hackup/C128Diag/README.md

# C128 Diagnostic Cartridge 325093-01 Replica

This is a 1:1 replica of the PCB for the Commodore C128 Diagnostic Test cartridge assy no. 325093-01. See my [blog post](https://www.hackup.net/2023/05/c128-diagnostic-cartridge-325093-01-replicated/) for more details.

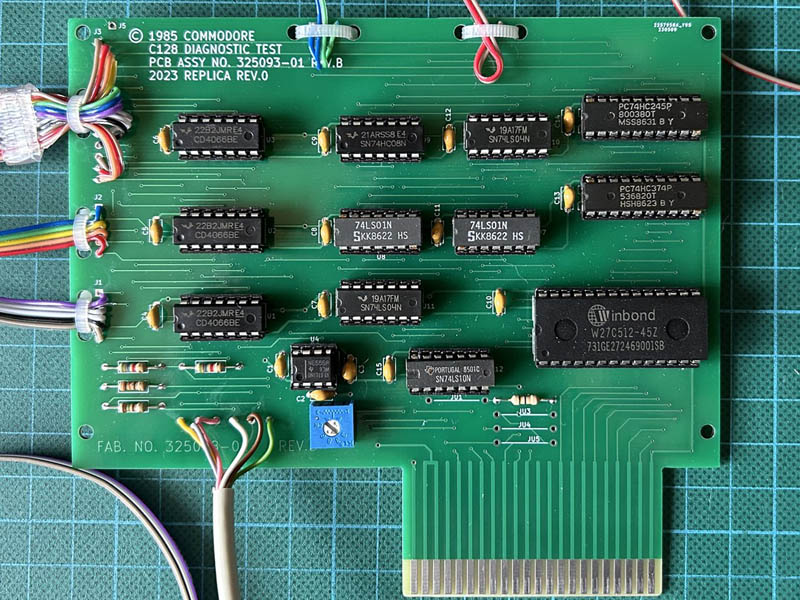
[picture p1: media/C128Diag-1.jpg]
C128Diag Replica Rev.0


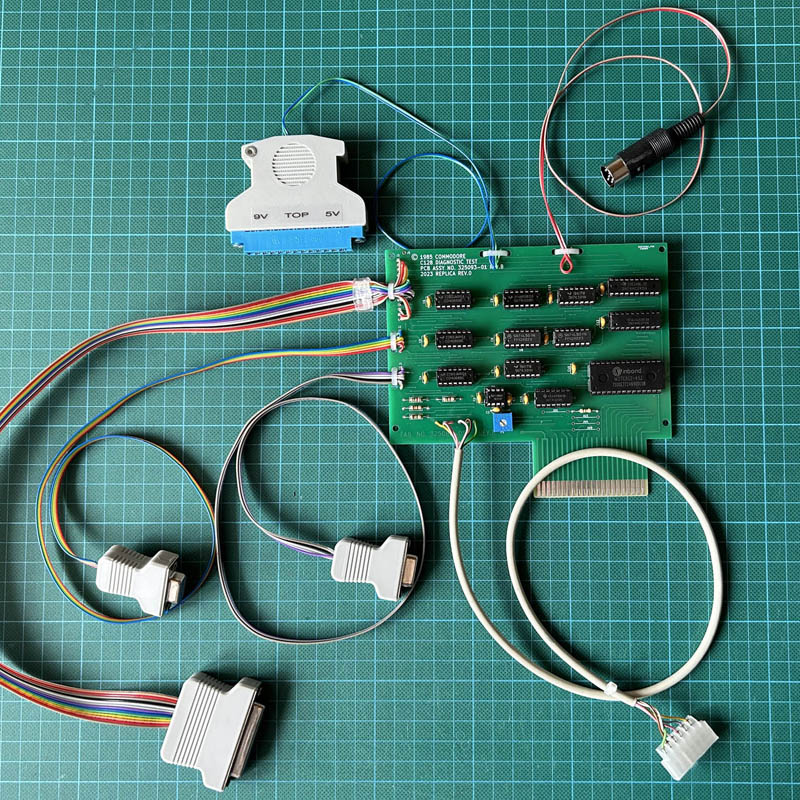
[picture p2: media/C128Diag-2.jpg]
C128Diag Replica Rev.0 with test harness


## License


This work is licensed under a
[Creative Commons Attribution-NonCommercial-ShareAlike 4.0 International License](http://creativecommons.org/licenses/by-nc-sa/4.0/).
