hackup/C128Diag/C128Diag.pdf

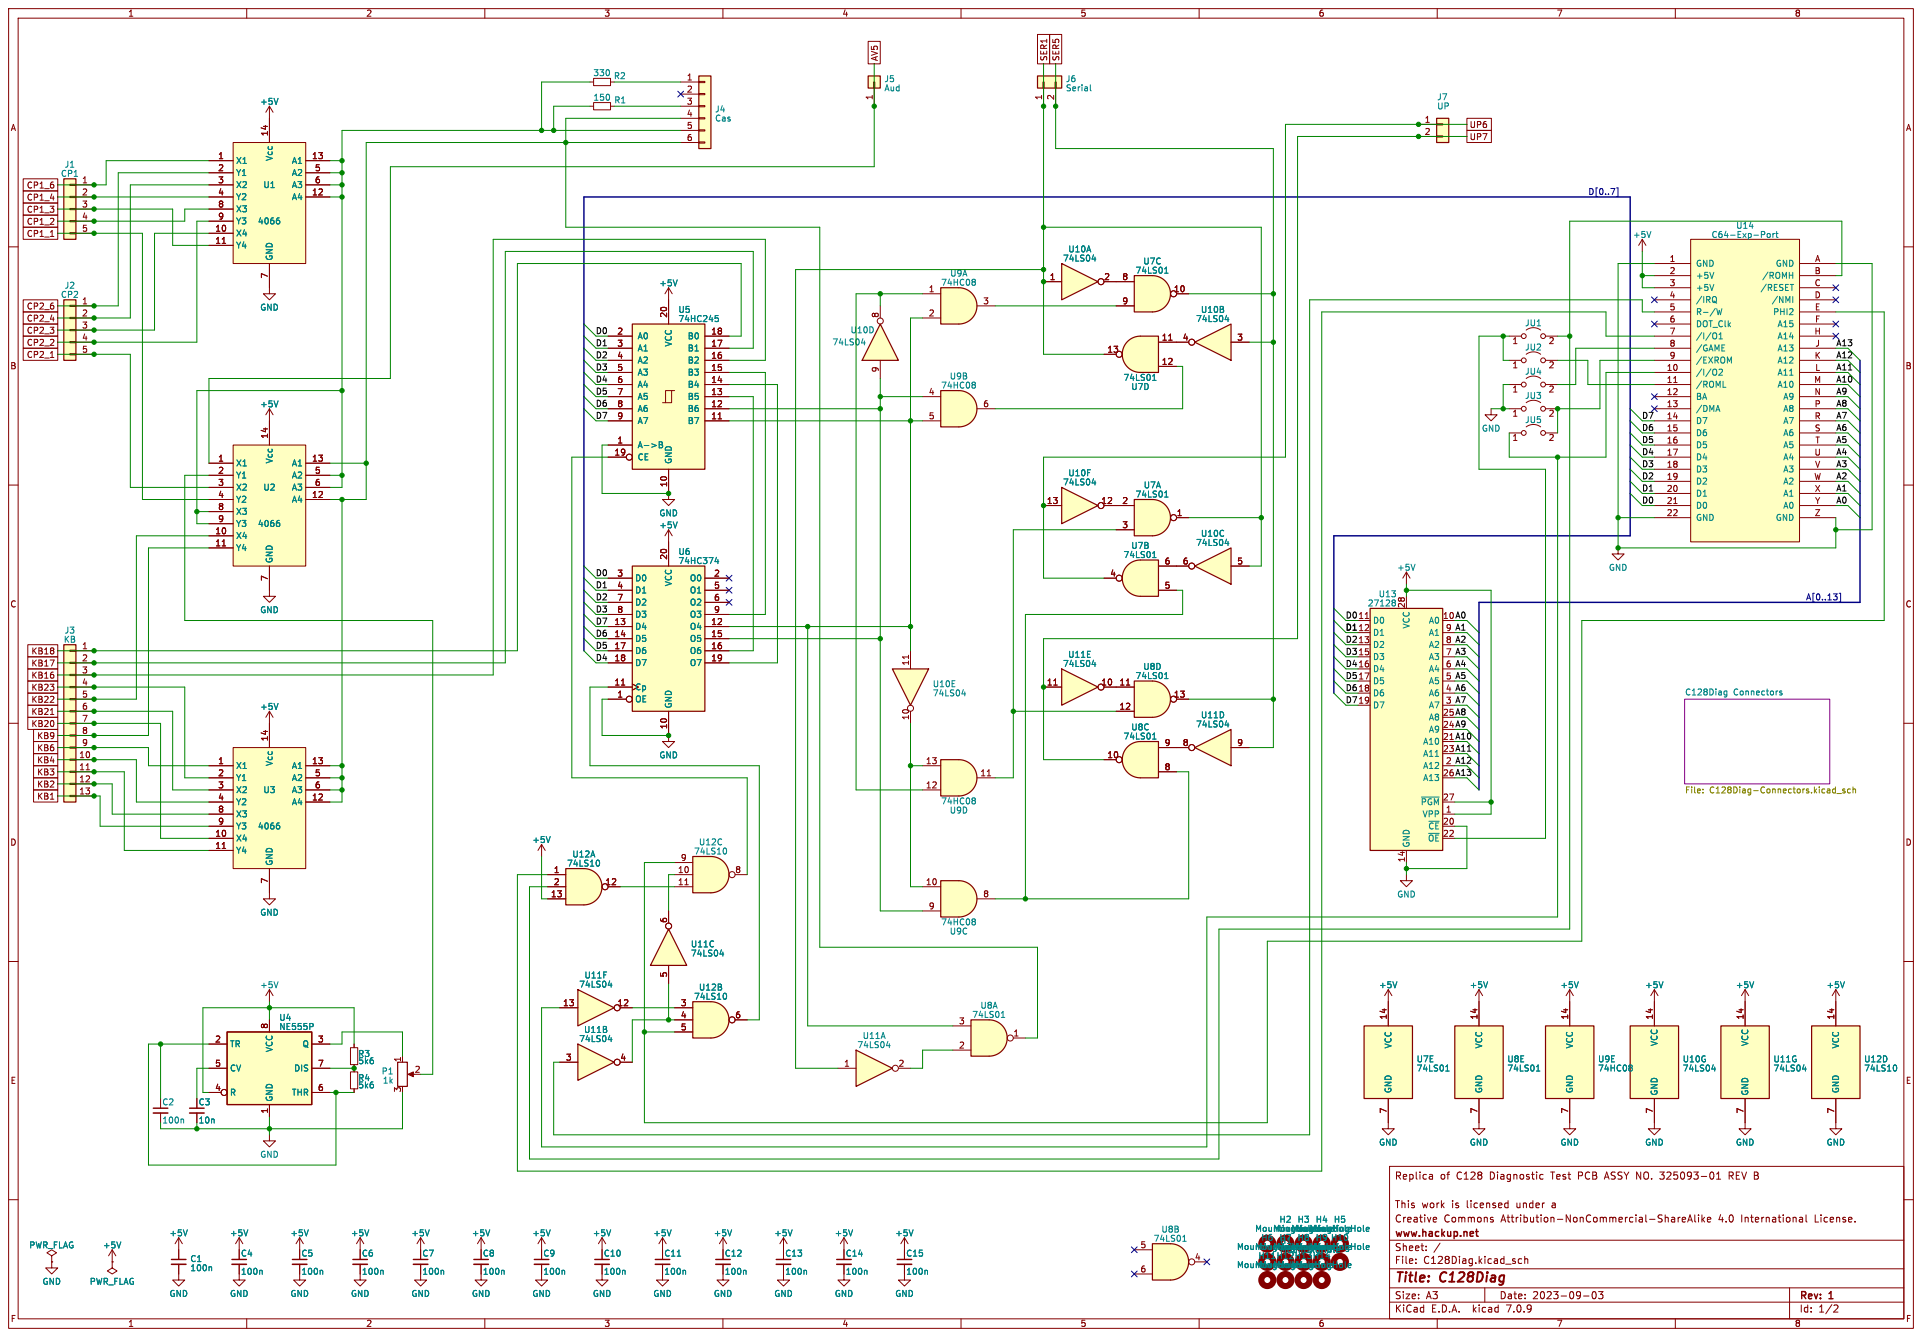
[picture p3: page 1]

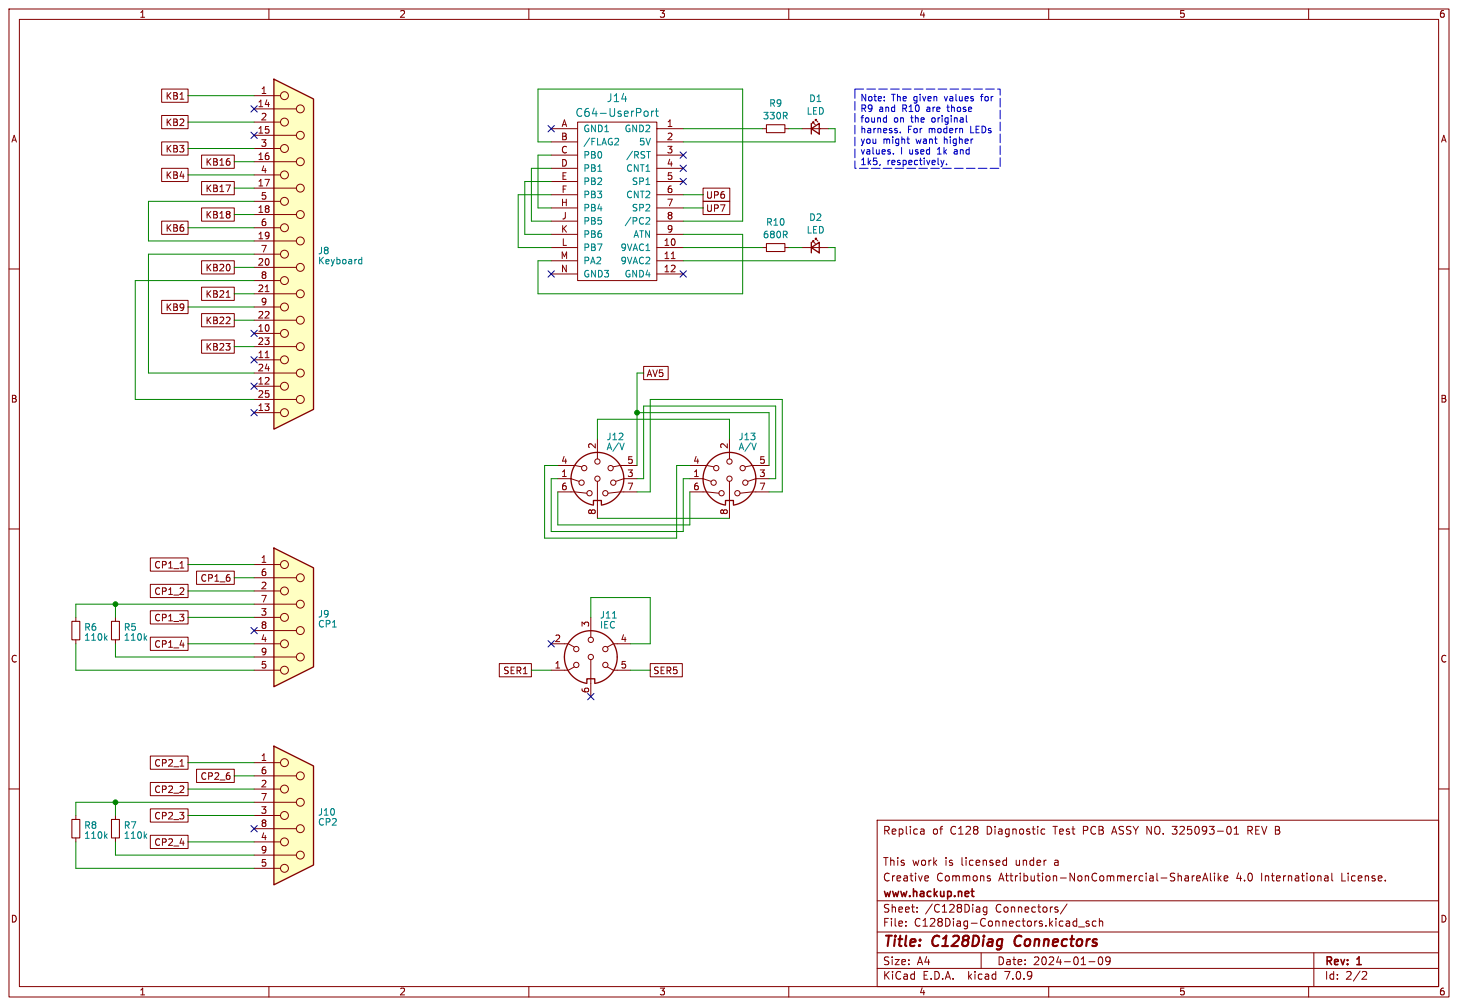
[picture p4: page 2]

found on the original harness. For modern LEDs

you might want higher values. I used 1k and
