hackup/C128Diag/C128Diag-Connectors.kicad_sch

## KiCad design C128Diag-Connectors.kicad_sch (2024-01-09)

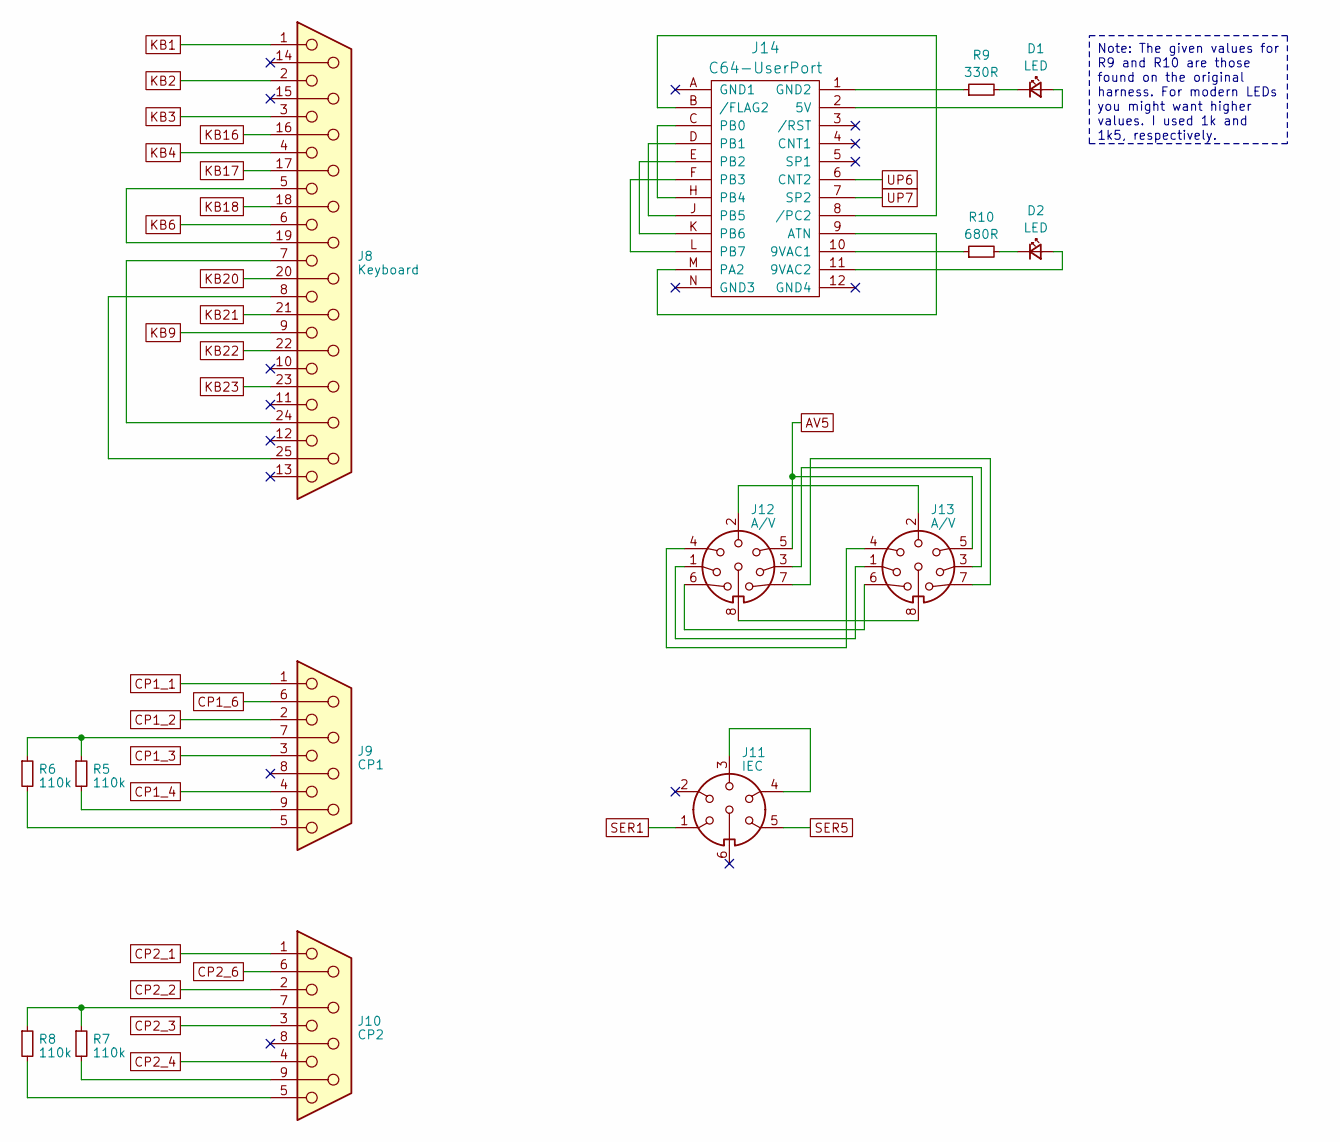
[picture p5: schematic C128Diag-Connectors.kicad_sch]

Parts:
D1, D2: LED
J8: Keyboard
J9: CP1
J10: CP2
J11: IEC
J12, J13: A/V
J14: C64-UserPort; C64-User-Port-Female
R5, R6, R7, R8: 110k
R9: 330R
R10: 680R

Connections:
AV5: J12.5, J13.5
CP1_1: J9.1
CP1_2: J9.2
CP1_3: J9.3
CP1_4: J9.4
CP1_6: J9.6
CP2_1: J10.1
CP2_2: J10.2
CP2_3: J10.3
CP2_4: J10.4
CP2_6: J10.6
KB1: J8.1
KB2: J8.2
KB3: J8.3
KB4: J8.4
KB6: J8.6
KB9: J8.9
KB16: J8.16
KB17: J8.17
KB18: J8.18
KB20: J8.20
KB21: J8.21
KB22: J8.22
KB23: J8.23
unnamed: D1.1 (K), R9.2
unnamed: D1.2 (A), J14.2 (5V)
unnamed: D2.1 (K), R10.2
unnamed: D2.2 (A), J14.11 (9VAC2)
unnamed: J8.5, J8.19
unnamed: J8.7, J8.24
unnamed: J8.8, J8.25
unnamed: J9.5, R6.2
unnamed: J9.7, R5.1, R6.1
unnamed: J9.9, R5.2
unnamed: J10.5, R8.2
unnamed: J10.7, R7.1, R8.1
unnamed: J10.9, R7.2
unnamed: J11.3, J11.4
unnamed: J12.1, J13.1
unnamed: J12.2, J13.2
unnamed: J12.3, J13.3
unnamed: J12.4, J13.4
unnamed: J12.6, J13.6
unnamed: J12.7, J13.7
unnamed: J12.8, J13.8
unnamed: J14.1 (GND2), R9.1
unnamed: J14.8 (/PC2), J14.B (/FLAG2)
unnamed: J14.9 (ATN), J14.M (PA2)
unnamed: J14.10 (9VAC1), R10.1
unnamed: J14.C (PB0), J14.H (PB4)
unnamed: J14.D (PB1), J14.J (PB5)
unnamed: J14.E (PB2), J14.K (PB6)
unnamed: J14.F (PB3), J14.L (PB7)
SER1: J11.1
SER5: J11.5
UP6: J14.6 (CNT2)
UP7: J14.7 (SP2)

Notes on the sheet:
Note: The given values for R9 and R10 are those found on the original harness. For modern LEDs you might want higher values. I used 1k and 1k5, respectively.
