hackup/C128Diag/C128Diag.kicad_sch

## KiCad design C128Diag.kicad_sch (2024-01-09)

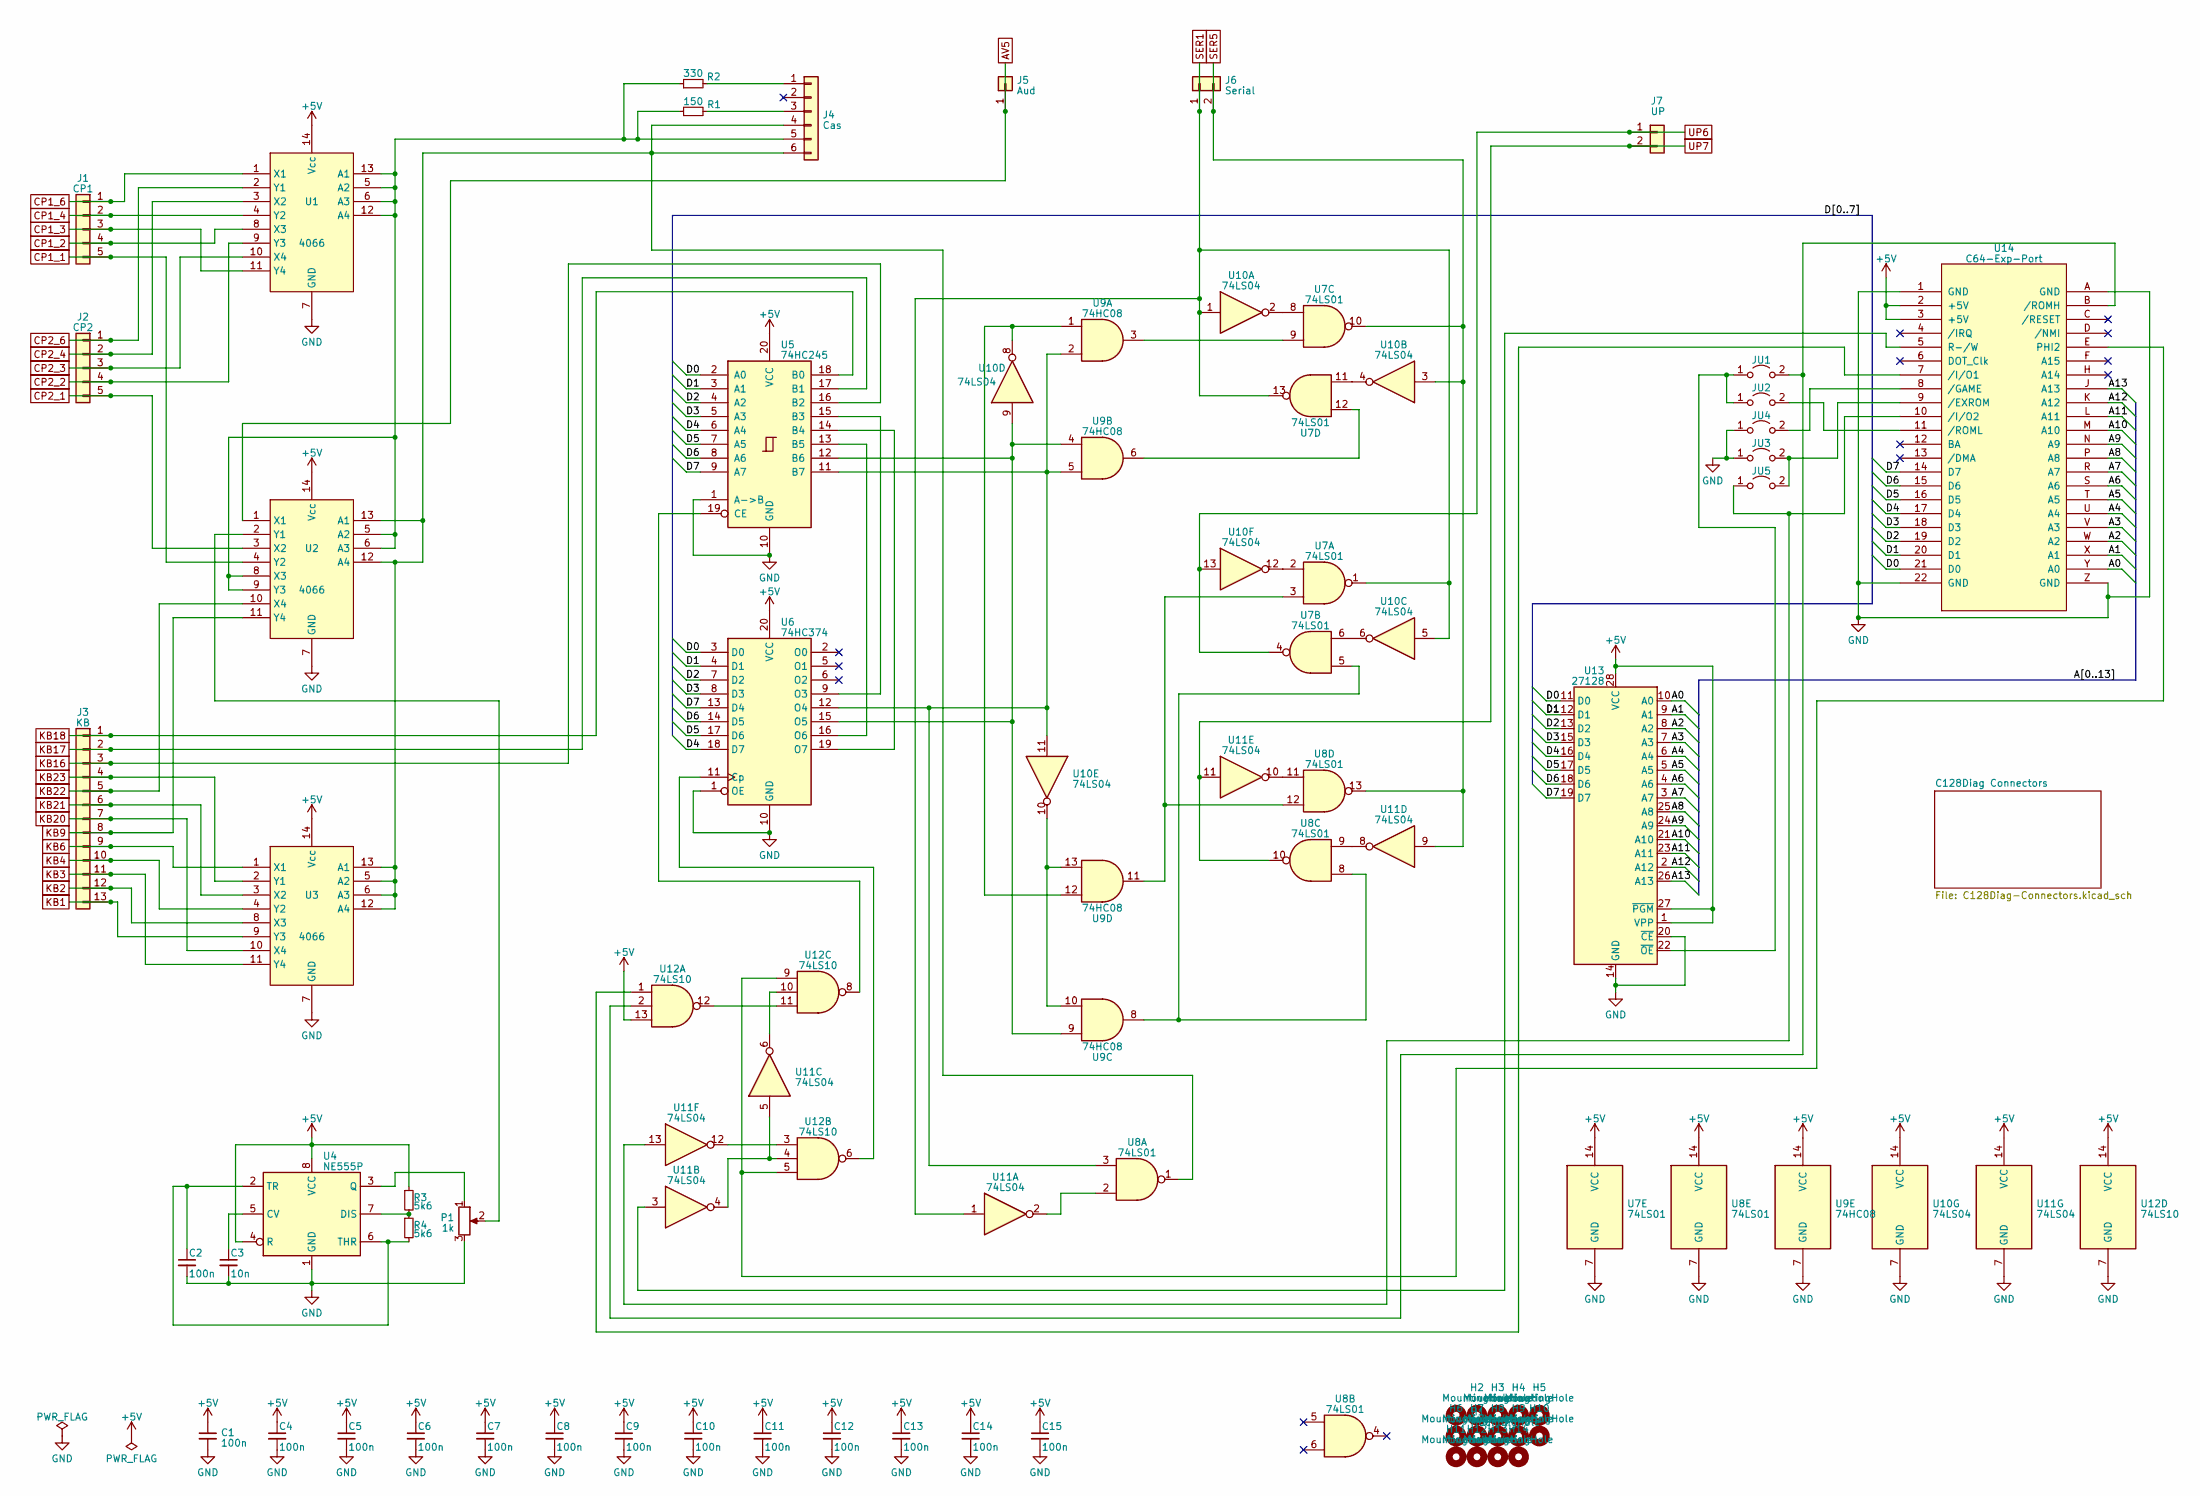
[picture p6: schematic C128Diag.kicad_sch]

Parts:
C1, C2, C4, C5, C6, C7, C8, C9, C10, C11, C12, C13, C14, C15: 100n; C_Disc_D4.7mm_W2.5mm_P5.00mm
C3: 10n; C_Disc_D4.7mm_W2.5mm_P5.00mm
H1, H2, H3, H4, H5, H6, H7, H8, H9, H10, H11, H12, H13, H14: MountingHole; Hole_3.2mm
J1: CP1; PinHeader_1x05_P2.54mm_Vertical
J2: CP2; PinHeader_1x05_P2.54mm_Vertical
J3: KB; PinHeader_1x13_P2.54mm_Vertical
J4: Cas; Cassete-C128Diag
J5: Aud; PinHeader_1x01_P2.54mm_Vertical
J6: Serial; PinHeader_1x02_P5.08mm_Vertical
J7: UP; PinHeader_1x02_P5.08mm_Vertical
JU1, JU2, JU3, JU4, JU5: Jumper_2_Open; Jumper
P1: 1k; Potentiometer_Bourns_3339P_Vertical
R1: 150; R_Axial_P12.70mm_Horizontal
R2: 330; R_Axial_P12.70mm_Horizontal
R3, R4: 5k6; R_Axial_P12.70mm_Horizontal
U1, U2, U3: 4066; DIP-14_W7.62mm
U4: NE555P; DIP-8_W7.62mm
U5: 74HC245; DIP-20_W7.62mm
U6: 74HC374; DIP-20_W7.62mm
U7, U8: 74LS01; DIP-14_W7.62mm
U9: 74HC08; DIP-14_W7.62mm
U10, U11: 74LS04; DIP-14_W7.62mm
U12: 74LS10; DIP-14_W7.62mm
U13: 27128; DIP-28_W15.24mm
U14: C64-Exp-Port; C64-Cart-C128Diag

Connections:
+5V: C1.1, C4.1, C5.1, C6.1, C7.1, C8.1, C9.1, C10.1, C11.1, C12.1, C13.1, C14.1, C15.1, R3.1, U1.14 (Vcc), U2.14 (Vcc), U3.14 (Vcc), U4.4 (R), U4.8 (VCC), U5.20 (VCC), U6.20 (VCC), U7.14 (VCC), U8.14 (VCC), U9.14 (VCC), U10.14 (VCC), U11.14 (VCC), U12.13, U12.14 (VCC), U13.1 (VPP), U13.27 (~PGM), U13.28 (VCC), U14.2 (+5V), U14.3 (+5V)
A0: U13.10 (A0), U14.Y (A0)
A1: U13.9 (A1), U14.X (A1)
A2: U13.8 (A2), U14.W (A2)
A3: U13.7 (A3), U14.V (A3)
A4: U13.6 (A4), U14.U (A4)
A5: U13.5 (A5), U14.T (A5)
A6: U13.4 (A6), U14.S (A6)
A7: U13.3 (A7), U14.R (A7)
A8: U13.25 (A8), U14.P (A8)
A9: U13.24 (A9), U14.N (A9)
A10: U13.21 (A10), U14.M (A10)
A11: U13.23 (A11), U14.L (A11)
A12: U13.2 (A12), U14.K (A12)
A13: U13.26 (A13), U14.J (A13)
AV5: J5.1, U2.1 (X1)
CP1_1: J1.5, U2.4 (Y2)
CP1_2: J1.4, U1.8 (X3)
CP1_3: J1.3, U1.11 (Y4)
CP1_4: J1.2, U1.4 (Y2)
CP1_6: J1.1, U1.1 (X1)
CP2_1: J2.5, U2.3 (X2)
CP2_2: J2.4, U1.9 (Y3)
CP2_3: J2.3, U1.10 (X4)
CP2_4: J2.2, U1.3 (X2)
CP2_6: J2.1, U1.2 (Y1)
D0: U5.2 (A0), U6.3 (D0), U13.11 (D0), U14.21 (D0)
D1: U5.3 (A1), U6.4 (D1), U13.12 (D1), U14.20 (D1)
D2: U5.4 (A2), U6.7 (D2), U13.13 (D2), U14.19 (D2)
D3: U5.5 (A3), U6.8 (D3), U13.15 (D3), U14.18 (D3)
D4: U5.6 (A4), U6.18 (D7), U13.16 (D4), U14.17 (D4)
D5: U5.7 (A5), U6.17 (D6), U13.17 (D5), U14.16 (D5)
D6: U5.8 (A6), U6.14 (D5), U13.18 (D6), U14.15 (D6)
D7: U5.9 (A7), U6.13 (D4), U13.19 (D7), U14.14 (D7)
GND: C1.2, C2.2, C3.2, C4.2, C5.2, C6.2, C7.2, C8.2, C9.2, C10.2, C11.2, C12.2, C13.2, C14.2, C15.2, JU3.1 (A), JU4.1 (A), P1.3, U1.7 (GND), U2.7 (GND), U3.7 (GND), U4.1 (GND), U5.1 (A->B), U5.10 (GND), U6.1 (OE), U6.10 (GND), U7.7 (GND), U8.7 (GND), U9.7 (GND), U10.7 (GND), U11.7 (GND), U12.7 (GND), U13.14 (GND), U13.20 (~CE), U14.1 (GND), U14.22 (GND), U14.A (GND), U14.Z (GND)
KB1: J3.13, U3.9 (Y3)
KB2: J3.12, U3.8 (X3)
KB3: J3.11, U3.11 (Y4)
KB4: J3.10, U3.4 (Y2)
KB6: J3.9, U3.1 (X1)
KB9: J3.8, U2.11 (Y4)
KB16: J3.3, U5.16 (B2)
KB17: J3.2, U5.17 (B1)
KB18: J3.1, U5.18 (B0)
KB20: J3.7, U3.10 (X4)
KB21: J3.6, U3.3 (X2)
KB22: J3.5, U2.10 (X4)
KB23: J3.4, U3.2 (Y1)
unnamed: C2.1, R4.2, U4.2 (TR), U4.6 (THR)
unnamed: C3.1, U4.5 (CV)
unnamed: J4.1, R2.2
unnamed: J4.3, R1.2
unnamed: J4.4, J4.6, U2.12 (A4), U2.13 (A1), U3.5 (A2), U3.6 (A3), U3.12 (A4), U3.13 (A1), U8.1
unnamed: J4.5, R1.1, R2.1, U1.5 (A2), U1.6 (A3), U1.12 (A4), U1.13 (A1), U2.5 (A2), U2.6 (A3), U2.8 (X3), U2.9 (Y3)
unnamed: JU1.1 (A), JU2.1 (A), U13.22 (~OE)
unnamed: JU1.2 (B), U12.2, U14.B (/ROMH)
unnamed: JU2.2 (B), U14.11 (/ROML)
unnamed: JU3.2 (B), JU5.2 (B), U14.9 (/EXROM)
unnamed: JU4.2 (B), U14.8 (/GAME)
unnamed: JU5.1 (A), U11.13, U14.10 (/I/O2)
unnamed: P1.1, U4.3 (Q)
unnamed: P1.2, U2.2 (Y1)
unnamed: R3.2, R4.1, U4.7 (DIS)
unnamed: U5.13 (B5), U6.16 (O6)
unnamed: U5.14 (B4), U6.19 (O7)
unnamed: U5.15 (B3), U6.9 (O3)
unnamed: U7.3, U8.12, U9.11
unnamed: U7.5, U8.8, U9.8
unnamed: U7.9, U9.3
unnamed: U7.12, U9.6
unnamed: U7.8, U10.2
unnamed: U7.11, U10.4
unnamed: U7.6, U10.6
unnamed: U9.1, U9.12, U10.8
unnamed: U5.12 (B6), U6.15 (O5), U9.4, U9.9, U10.9
unnamed: U9.10, U9.13, U10.10
unnamed: U5.11 (B7), U6.12 (O4), U8.3, U9.2, U9.5, U10.11
unnamed: U7.2, U10.12
unnamed: U8.2, U11.2
unnamed: U11.3, U14.5 (R-/W)
unnamed: U11.4, U11.5, U12.4
unnamed: U11.6, U12.10
unnamed: U8.9, U11.8
unnamed: U8.11, U11.10
unnamed: U11.12, U12.3
unnamed: U12.1, U14.7 (/I/O1)
unnamed: U12.5, U12.9, U14.E (PHI2)
unnamed: U6.11 (Cp), U12.6
unnamed: U5.19 (CE), U12.8
unnamed: U12.11, U12.12
SER1: J6.1, U7.1, U7.13, U10.1, U10.5, U11.1
SER5: J6.2, U7.10, U8.13, U10.3, U11.9
UP6: J7.1, U7.4, U10.13
UP7: J7.2, U8.10, U11.11
