hackup/C128Diag/(threads)

Thread 1 (2024-01-09):

missing user port connector

au-chadl, 2024-01-09:
the connectors schematic is missing the user port connector

Closed 2024-01-09.

Thread 2 (2024-07-05):

J6/J7 - round pad seems slightly smaller

hexbus, 2024-07-05:
First - thank you for the excellent build.  I have it all working except the harnesses, which I'm working on.  I have been trying to obtain some removable pin headers that fit, and, in the process, noticed that all the jumper harness holes are 1.0mm except the round pads on J6/J7.  Those appear to be 0.75mm or so.  Was this intentional to make these two round pads smaller?

If not, consider this something that I found as I was trying to fit a square pin into a round hole ;)

Thank you!

hexbus, 2024-07-05:
No problem, thanks for fixing it!  I will likely use normal pin headers for those two jacks for now.  I’m trying to keep my harnesses removable, and will just have two DuPont connectors on those.

Closed 2024-07-05.
