hackup/C128Diag/(commit log)

2023-05-01 Initial import.
    [C128Diag.kicad_sch]
2023-05-01 Tracing traces and reconstructing schematics.
    [C128Diag.kicad_sch]
2023-05-02 Tracing traces and reconstructing schematics, might be complete.
    [C128Diag.kicad_sch]
2023-05-03 Cleaning up schematics.
    [C128Diag.kicad_sch]
2023-05-04 Cleaning up board layout.
    [C128Diag.kicad_sch]
2023-05-16 Fixed potentiometer footprint.
2023-06-02 Adding connector wiring to schematics.
    [C128Diag.kicad_sch]
2024-01-09 Added missing user port connector wiring, fixes #1.
    [C128Diag-Connectors.kicad_sch, C128Diag.kicad_sch]
2024-07-05 Corrected drill hole diameter of pin 2 on both J6 an J7, fix #2.
